jpasqua/PurpleHaze/(threads)

Thread 3 (2020-10-03):

Fix base of stand in 3D model of Housing

jpasqua, 2020-10-03:
The base of the of the housing is too weak. In particular, the spars that are at the bottom of the base between legs. Make them thicker. Perhaps add cross-members.

jpasqua, 2020-10-08:
A sturdier bse has been designed and tested. Still needs to be uploaded to thingiverse.

jpasqua, 2020-10-29:
On thingiverse: https://www.thingiverse.com/thing:4607364/

Closed 2020-10-29.

Thread 7 (2021-07-24):

Compile Error uint8_t {aka unsigned char}

kemac, 2021-07-24:
In file included from C:\Users\kemac\Downloads\PurpleHaze-master\PurpleHaze-master\PurpleHaze\PurpleHaze.ino:18:

C:\Users\kemac\Documents\Arduino\libraries\PurpleHaze-master/SecondarySerial.h: In member function 'void SecondarySerial::begin()':

C:\Users\kemac\Documents\Arduino\libraries\PurpleHaze-master/SecondarySerial.h:18:44: error:  to 'SerialMode' [-fpermissive]

   18 |       hs->begin(SensorBaudRate,SERIAL_8N1, SENSOR_RX_PIN, SENSOR_TX_PIN);

      |                                            ^~~~~~~~~~~~~

      |                                            |

      |                                            uint8_t {aka unsigned char}

In file included from C:\Users\kemac\AppData\Local\Arduino15\packages\esp8266\hardware\esp8266\3.0.1\cores\esp8266/Arduino.h:288,

                 from sketch\PurpleHaze.ino.cpp:1:

C:\Users\kemac\AppData\Local\Arduino15\packages\esp8266\hardware\esp8266\3.0.1\cores\esp8266/HardwareSerial.h:87:68: note:   initializing argument 3 of 'void HardwareSerial::begin(long unsigned int, SerialConfig, SerialMode, uint8_t)'

   87 |     void begin(unsigned long baud, SerialConfig config, SerialMode mode, uint8_t tx_pin)

      |                                                         ~~~~~~~~~~~^~~~

exit status 1
Error compiling for board LOLIN(WEMOS) D1 mini Pro.
