jpasqua/PurpleHaze/HWConfig.h

#ifndef HWConfig_h
#define HWConfig_h

#include <Arduino.h>

// ----- BEGIN: Constants used in the rest of the file. Do not change these
// An enumeration of allowable values for HWConfig
#define Config_Custom        1
#define Config_D1Mini        2
#define Config_ESP32Mini     3
// ----- END: Constants used in the rest of the file

// Pick a configuration. Use Config_Custom to define your own
#define HWConfig Config_D1Mini

// Does this config include a Temp/Humidity/Pressure Sensor?
#define HAS_THP_SENSOR


#if (HWConfig == Config_D1Mini)
  /*------------------------------------------------------------------------------
   *
   * Config Info for D1 Mini
   *
   *----------------------------------------------------------------------------*/

  // ----- Air Quality Sensor
  #define USE_SW_SERIAL 1
  constexpr uint8_t SENSOR_RX_PIN = D6;
  constexpr uint8_t SENSOR_TX_PIN = D8;

  constexpr int8_t NEOPIXEL_PIN = D2;

  #if defined(HAS_THP_SENSOR)
    constexpr uint8_t BME_I2C_ADDR = 0x76;
    constexpr uint8_t SDA_PIN = D1;
    constexpr uint8_t SCL_PIN = D5;
  #endif  // HAS_THP_SENSOR

#elif (HWConfig == Config_ESP32Mini)
  /*------------------------------------------------------------------------------
   *
   * Config Info for ESP32D1Mini
   *
   *----------------------------------------------------------------------------*/

  // ----- Air Quality Sensor
  constexpr uint8_t SENSOR_RX_PIN = 16;
  constexpr uint8_t SENSOR_TX_PIN = 17;

  constexpr int8_t NEOPIXEL_PIN = 21;

  #if defined(HAS_THP_SENSOR)
    constexpr uint8_t BME_I2C_ADDR = 0x76;
    constexpr uint8_t SDA_PIN = D1;
    constexpr uint8_t SCL_PIN = D5;
  #endif  // HAS_THP_SENSOR

#elif (HWConfig ==  Config_Custom)
  /*------------------------------------------------------------------------------
   *
   * Custom Config - put your settings here
   *
   *----------------------------------------------------------------------------*/

  // ----- Air Quality Sensor
  #define USE_SW_SERIAL 1
  constexpr uint8_t SENSOR_RX_PIN = D6;
  constexpr uint8_t SENSOR_TX_PIN = D8;

  #if defined(HAS_THP_SENSOR)
    constexpr uint8_t BME_I2C_ADDR = 0x76;
    constexpr uint8_t SDA_PIN = D1; // Set to -1 to use default I2C Pins
    constexpr uint8_t SCL_PIN = D5;
  #endif  // HAS_THP_SENSOR

  // If there are NeoPixels connected to use as status indicators, set the pin
  // that drives the data line. If no NeoPixels are connected, set the pin to -1
  constexpr int8_t NEOPIXEL_PIN = D2;

#else
    #error "Please set HWConfig"
#endif


#endif  // HWConfig_h
