jpasqua/PurpleHaze/PHWebUI.h

/*
 * PHWebUI:
 *    Implements the WebUI for PurpleHaze
 *
 */

#ifndef PHWebUI_h
#define PHWebUI_h

#include <WebUI.h>

namespace PHWebUI {
  // ----- Setup functions
  void init();
}

#endif  // PHWebUI_h
