jpasqua/PurpleHaze/(commit log)

2020-09-12 Prep sensor after time has been established
2020-09-26 Add PCB design
2020-09-26 Update docs for 3D Model and PCB
2020-10-01 Rename AQM to PurpleHaze (PH for short)
    [PHSettings.cpp, PHSettings.h, PHWebUI.cpp, PHWebUI.h, PurpleHaze.ino]
2020-10-01 Missing Blynk key -> empty key
    [PHSettings.cpp]
2020-10-04 Update AQI Colors for LED
2020-10-06 Change stored value mechanism (see details)
    * For the 1hr interval, keep 5-minute granularity, not 10.
    * When keeping historical samples, do it based on deltas from the last timestamp
    * Update so powering off/on won't cause extra historical samples
    * reflect user-visible changes in the README
2020-10-13 Show another wiring option
2020-10-25 Weekly samples at 12hr intervals. Fix typos. Update Docs.
2020-11-02 Reorg data structures
    * Keep track of just PM_ENV readings for historical data, not the full AQIReadings structure
    * Double number of samples kept per day
    * Remove 1day & 1wk moving averages
    * Update docs
2020-11-28 Generalize for ESP32
2020-11-28 Update to refelct ESP32 support
2020-11-28 Further updates for ESP32 support
2020-12-06 Fixed ESP8266 issues introduced with ESP32 code
2021-09-16 Initial commit of new Weather integration
    * First step of reorganizing file structure
    * Introduce use of HistoryBuffer to keep track of weather and AQI data
    * Introduce notion of AQIMgr nd WeatherMgr for handling sensors
2021-09-21 Sensor configuration - for now just weather sensors
2021-09-21 Add items related to an optional weather sensor
2021-09-21 Support for optional weather sensor
2021-09-23 Add temperature to Chart page, improve visuals
2021-09-24 One decimal place for temperature. Use correct property name for temperature.
2021-09-28 List a couple of predefined configs
2023-05-30 Use Basics::Pin
2023-06-12 Remove unneeded workaround for warning
    [PurpleHazeApp.cpp]
2023-07-13 Improve temp and humidity calibration
2023-07-22 finer control over the presence of control buttons
2026-01-18 Fix display of dew point
    [PHWebUI.cpp]
2026-01-18 Fix one of the hardware configs
    [HWConfig.h]
